PHS-SMCS/falcon-flight/images/README.md

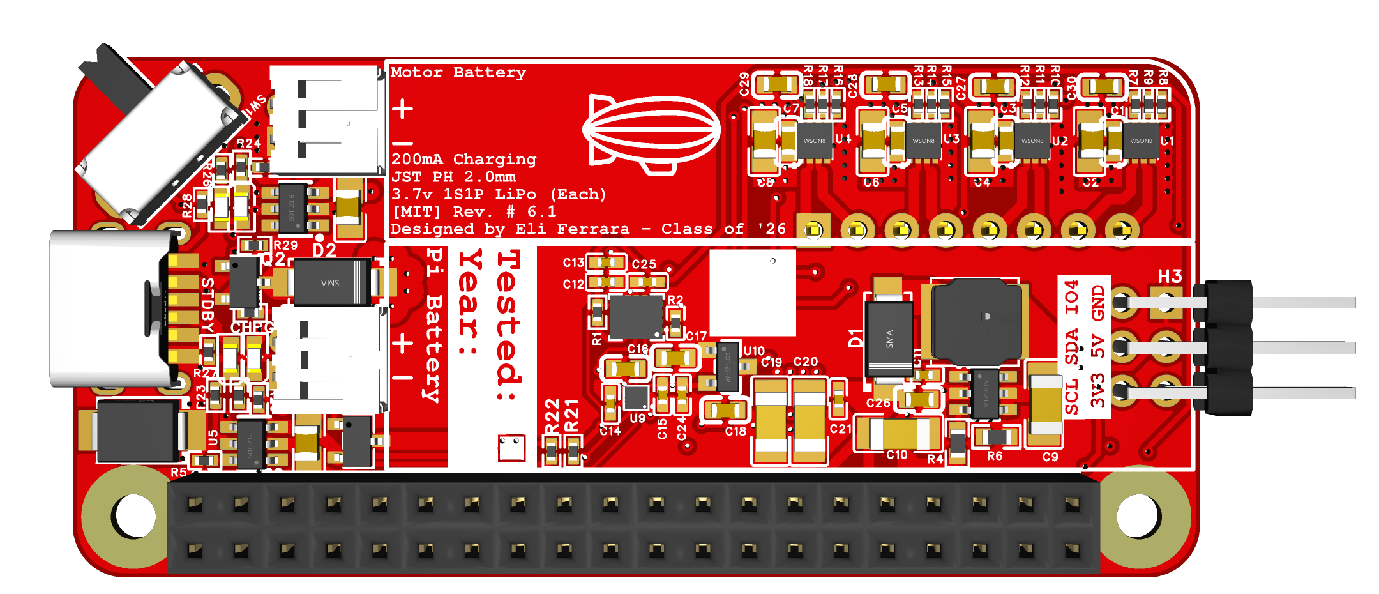
[picture p2: images/FFB6.1_3D_Top.png]
Falcon Flight embedded controller board 3D view (Top)


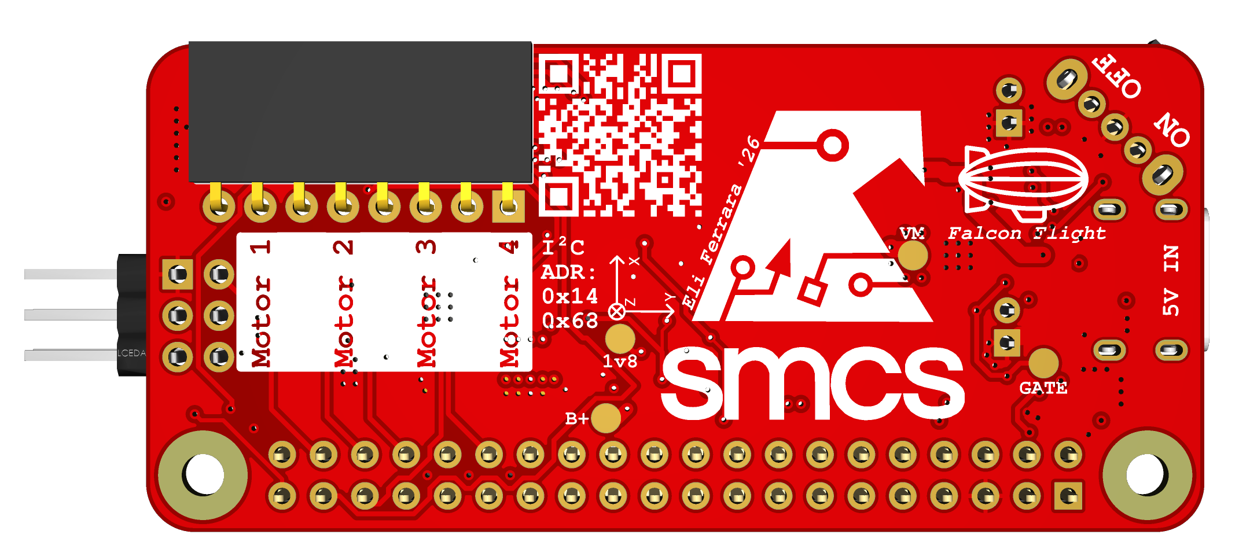
[picture p3: images/FFB6.1_3D_Bottom.png]
Falcon Flight embedded controller board 3D view (Bottom)


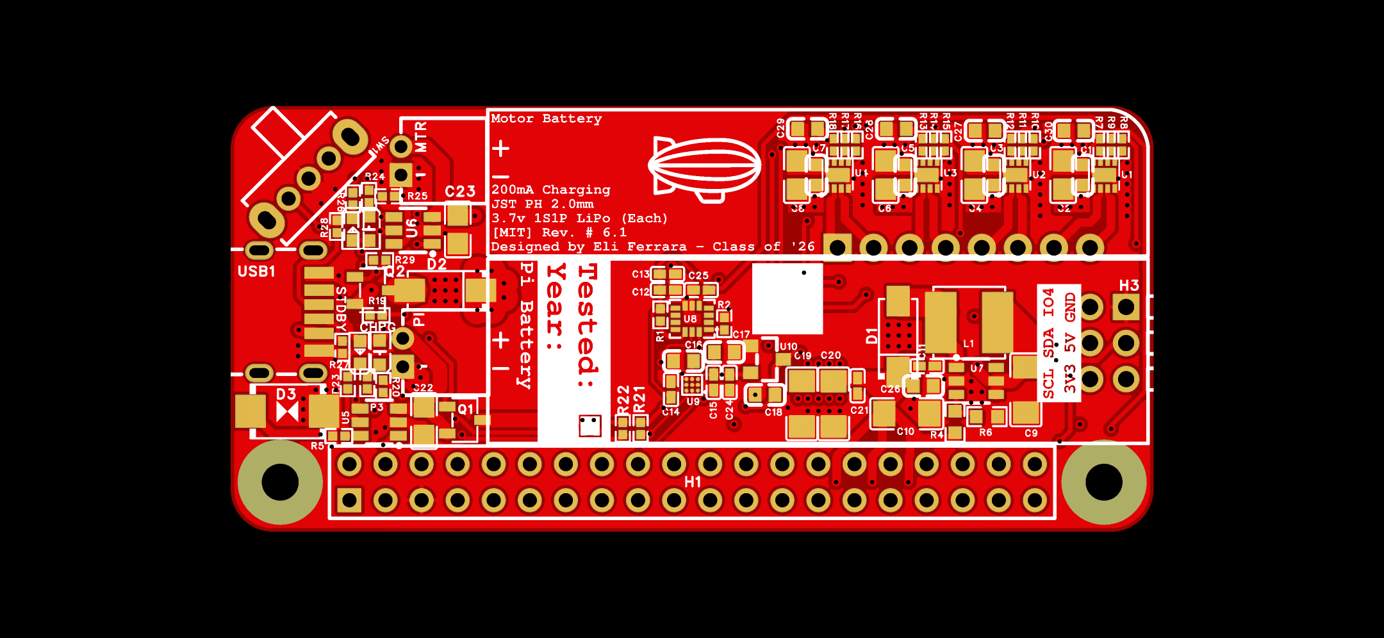
[picture p4: images/FFB6.1_2D_Top.png]
Falcon Flight embedded controller board 2D view (Top, no components)


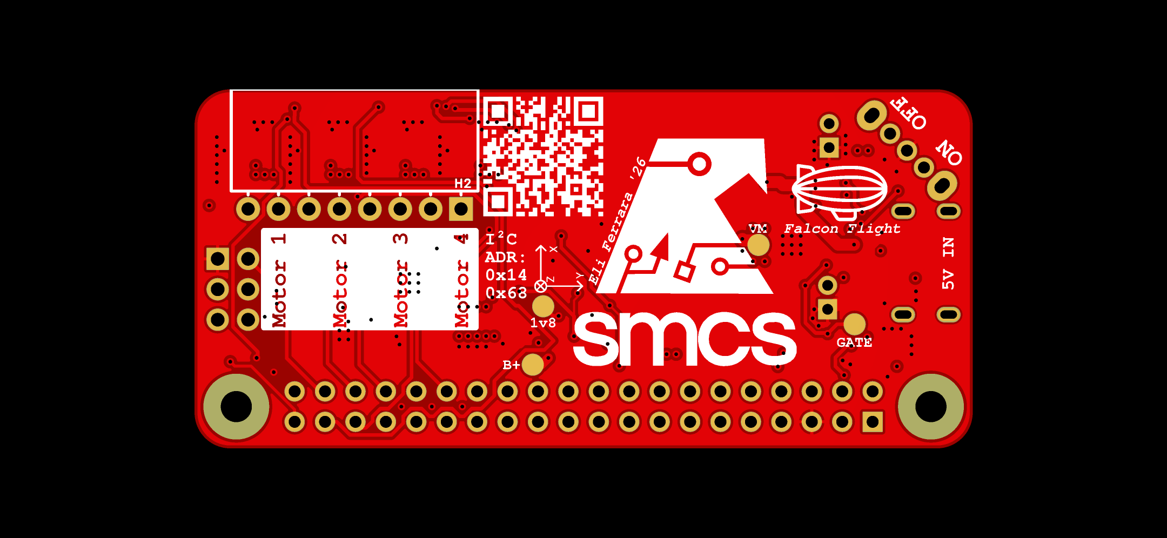
[picture p5: images/FFB6.1_2D_Bottom.png]
Falcon Flight embedded controller board 2D view (Bottom, no components)
