PHS-SMCS/falcon-flight/docs/FFB6.1_BOM.xlsx

No. | Quantity | Comment | Footprint | Value | Manufacturer Part | JLCPCB Price | JLCPCB Stock | Designator | JLCPCB Part Class | Supplier Part | LCSC Part Name | Name | Unique ID | Device
1 | 1 | 1uF | C0603 | 1uF | CL10A105KB8NNNC | 0.0007 | 16204341 | C26 | Basic Part | C15849 | 1uF ±10% 50V | 1uF | gge3106 | CL10A105KB8NNNC
2 | 1 | 6.8uH | IND-SMD_L5.0-W5.0 | 6.8uH | SWPA5020S6R8MT | 0.0137 | 2788 | L1 | Extended Part | C36410 | 6.8uH ±20% 2.05A | 6.8uH | gge3073 | SWPA5020S6R8MT
3 | 1 | 10uF | C1206 | 10uF | CL31A106KBHNNNE | 0.0048 | 2531080 | C20 | Basic Part | C13585 | 10uF ±10% 50V | 10uF | gge3098 | CL31A106KBHNNNE
4 | 1 | 30kΩ | R0603 |  | 0603WAF3002T5E | 0.0002 | 1803478 | R6 | Basic Part | C22984 |  | 30kΩ | gge31ab9c0f1dda5151 | 30kΩ
5 | 1 | 100nF | C0402 | 100nF | CL05B104KB54PNC | 0.0007 | 8856169 | C11 | Basic Part | C307331 | 100nF ±10% 50V | 100nF | gge3107 | CL05B104KB54PNC
6 | 1 | 100uF | C1206 | 100uF | CL31A107MQHNNNE | 0.01 | 1665954 | C19 | Basic Part | C15008 | 100uF ±20% 6.3V | 100uF | gge3097 | CL31A107MQHNNNE
7 | 1 | 100Ω | R0402 | 100Ω | 0402WGF1000TCE | 0.0001 | 5241737 | R29 | Basic Part | C25076 | 100Ω ±1% 62.5mW 厚膜电阻 | 100Ω | gge3145 | 0402WGF1000TCE
8 | 1 | 220kΩ | R0603 |  | 0603WAF2203T5E | 0.0002 | 779383 | R4 | Basic Part | C22961 |  | 220kΩ | ggefa30a2f02046dec0 | 220kΩ
9 | 1 | A2541WR-2x3P | HDR-TH_6P-P2.54-H-R2-C3-S2.54-W10.0_A2541WR |  | A2541WR-2x3P | 0.0145 | 67 | H3 | Extended Part | C239334 | 2x3P 间距:2.54mm 方针 弯插 | A2541WR-2x3P | gge3115 | A2541WR-2x3P
10 | 1 | BMI270 | LGA-14_L3.0-W2.5-P0.50-BR |  | BMI270 | 0.2565 | 14489 | U8 | Extended Part | C2836813 | BMI270 | BMI270 | gge3075 | BMI270
11 | 1 | BMM350 | WLCSP-9_L1.3-W1.3-R3-C3-P0.40-TL |  | BMM350 | 0.3041 | 3140 | U9 | Extended Part | C17225907 | SHUTTLE BOARD 3.0 BMM350 | BMM350 | gge3082 | BMM350_C17225907
12 | 1 | ME6206A18XG | SOT-23_L2.9-W1.3-P1.90-LS2.4-BR |  | ME6206A18XG | 0.0052 | 1772 | U10 | Extended Part | C236707 | 输入6V 输出1.8V 120mA | ME6206A18XG | gge3084 | ME6206A18XG
13 | 1 | MT3608 | SOT-23-6_L2.9-W1.6-P0.95-LS2.8-BR |  | MT3608 | 0.0084 | 116259 | U7 | Extended Part | C84817 |  | MT3608 | gge1bdc0ab44f99f92d | MT3608
14 | 1 | P6SMB6.8CA/TR13 | SMB_L4.6-W3.6-LS5.3-BI |  | P6SMB6.8CA/TR13 | 0.0072 | 249970 | D3 | Basic Part | C78395 | P6SMB6.8CA/TR13 | P6SMB6.8CA/TR13 | gge3103_1 | P6SMB6.8CA/TR13
15 | 1 | Pi Zero Header | HDR-TH_40P-P2.54-V-F-R2-C20-S2.54 |  | 2.54-2*20P母 | 0.0298 | 2 | H1 | Extended Part | C50982 |  | Pi Zero Header | gge60a270d9b08a2339 | Pi Zero Header
16 | 1 | PM254-1-08-W-8.5 | HDR-TH_8P-P2.54-H-F-W10.0-N |  | PM254-1-08-W-8.5 | 0.0243 | 158 | H2 | Extended Part | C2897390 | 1x8P 间距:2.54mm 弯插 | PM254-1-08-W-8.5 | gge3104_1 | PM254-1-08-W-8.5
17 | 1 | SK12D07VG3 | SW-TH_SK12D07VG3 |  | SK12D07VG3 | 0.0034 | 36037 | SW1 | Extended Part | C431547 | 两档位卧式拨动开关,柄长3MM | SK12D07VG3 | gge3071 | SK12D07VG3_C431547
18 | 1 | USB-TYPE-C-6PIN | USB-C-SMD-6P |  | TYPE-C-31-M-17 | 0.0259 | 3535 | USB1 |  | C283540 |  | USB-TYPE-C-6PIN | gge650f69c103efb29f_1 | USB-TYPE-C-6PIN
19 | 2 | 1kΩ | R0402 |  | 0402WGF1001TCE | 0.0001 | 10230811 | R3,R24 | Basic Part | C11702 |  | 1kΩ | gge3d69bb820fdd073a_1,gge3d69bb820fdd073a_3 | 1kΩ
20 | 2 | 2.2kΩ | R0402 | 2.2kΩ | 0402WGF2201TCE | 0.0001 | 2358701 | R21,R22 | Basic Part | C25879 | 2.2kΩ ±1% 62.5mW 厚膜电阻 | 2.2kΩ | gge3080,gge3081 | 0402WGF2201TCE
21 | 2 | 10uF | C0402 | 10uF | CL05A106MQ5NUNC | 0.0009 | 1838785 | C24,C25 | Basic Part | C15525 | 10uF ±20% 6.3V | 10uF | gge3101,gge3102 | CL05A106MQ5NUNC
22 | 2 | 10uF | C0805 |  | CL21A106KAYNNNE | 0.0016 | 8627909 | C22,C23 | Basic Part | C15850 |  | 10uF | gge6bc77ea4e09c62ca_1,gge6bc77ea4e09c62ca_2 | 10uF
23 | 2 | 22uF | C1206 | 22uF | CL31A226KAHNNNE | 0.0072 | 2097094 | C9,C10 | Basic Part | C12891 | 22uF ±10% 25V | 22uF | gge8af915fd353daa75,gge23753bbb746487b4 | CL31A226KAHNNNE
24 | 2 | Battery Connector | HDR-TH_2P-P2.00-H-F-W6.0 |  | Battery Connector | 0.0016 | 4907 | MTR,PI | Extended Part | C19271344 | 1x2P 间距:2mm 弯插 | Battery Connector | gge3072_2,gge3072_3 | XY-PH2.0-2A21
25 | 2 | DMP2035U-7 | SOT-23-3_L2.9-W1.6-P1.90-LS2.8-BR |  | DMP2035U-7 | 0.0084 | 82712 | Q1,Q2 | Extended Part | C110499 | 1个P沟道 耐压:20V 电流:3.6A | DMP2035U-7 | gge3112,gge3113 | DMP2035U-7
26 | 2 | NCD0603G3 | LED0603-RD |  | NCD0603G3 | 0.0012 | 48988 | STDBY,STDBY1 | Extended Part | C7429914 | NCD0603G3 | NCD0603G3 | gge3109,gge3111 | NCD0603G3
27 | 2 | RED_0603 | LED0603-R-RD |  | KT-0603R | 0.0008 | 4670572 | CHRG,CHRG1 | Basic Part | C2286 |  | RED_0603 | gge198_1,gge198_2 | RED_0603
28 | 2 | SS54 | SMA_L4.4-W2.8-LS5.4-R-RD |  | SS54 | 0.0061 | 1012443 | D1,D2 | Basic Part | C22452 | 电压:40V 电流:5A | SS54 | gge3150,gge3151 | SS54_C22452
29 | 2 | TP4057 | SOT-23-6_L2.9-W1.6-P0.95-LS2.8-BR |  | TP4057 | 0.0063 | 2992 | U5,U6 | Extended Part | C725791 | TP4057 | TP4057 | gge3108,gge3110 | TP4057
30 | 3 | 2.2uF | C0603 | 2.2uF | CL10A225KO8NNNC | 0.0009 | 4655966 | C16,C17,C18 | Basic Part | C23630 | 2.2uF ±10% 16V | 2.2uF | gge3083,gge3085,gge3086 | CL10A225KO8NNNC
31 | 4 | 5.1kΩ | R0402 |  | 0402WGF5101TCE | 0.0001 | 4244377 | R5,R25,R27,R28 | Basic Part | C25905 |  | 5.1kΩ | gge32fb4dae736d5b7f_2,ggeceda860c61fc78fa_1,ggeceda860c61fc78fa_2,ggeceda860c61fc78fa_3 | 5.1kΩ
32 | 4 | 22uF | C0805 | 22uF | CL21A226MAQNNNE | 0.0054 | 1988899 | C2,C4,C6,C8 | Basic Part | C45783 | 22uF ±20% 25V | 22uF | gge3138_1,gge3138_2,gge3138_3,gge3138_4 | CL21A226MAQNNNE
33 | 4 | 100kΩ | R0402 | 100kΩ | 0402WGF1003TCE | 0.0001 | 2837423 | R1,R2,R19,R20 | Basic Part | C25741 | 100kΩ ±1% 62.5mW 厚膜电阻 | 100kΩ | gge3076,gge3076_1,gge3076_2,gge3077 | 0402WGF1003TCE
34 | 4 | DRV8212PDSGR | WSON-8_L2.0-W2.0-P0.50-TL-EP |  | DRV8212PDSGR | 0.0583 | 81 | U1,U2,U3,U4 | Extended Part | C5208051 | DRV8212PDSGR | DRV8212PDSGR | gge3146,gge3147,gge3148,gge3149 | DRV8212PDSGR
35 | 5 | 100nF | C0402 | 100nF | CL05B104KO5NNNC | 0.0002 | 14759575 | C12,C13,C14,C15,C21 | Basic Part | C1525 | 100nF ±10% 16V | 100nF | gge23c53a2b242c8fec_1,gge3099,gge4817092b2fb4900c_1,gge4817092b2fb4900c_4,gge4817092b2fb4900c_5 | CL05B104KO5NNNC
36 | 6 | 10kΩ | R0402 | 10kΩ | 0402WGF1002TCE | 0.0001 | 15750299 | R9,R12,R15,R18,R23,R26 | Basic Part | C25744 | 10kΩ ±1% 62.5mW 厚膜电阻 | 10kΩ | gge3091_1,gge3091_2,gge3091_3,gge3091_4,gge3091_5,gge3124 | 0402WGF1002TCE
37 | 8 | 100nF | C0603 | 100nF | CC0603KRX7R9BB104 | 0.0004 | 57806501 | C1,C3,C5,C7,C27,C28,C29,C30 | Basic Part | C14663 | 100nF ±10% 50V | 100nF | gge3137_1,gge3137_2,gge3137_3,gge3137_4,gge3137_5,gge3137_6,gge3137_7,gge3137_8 | CC0603KRX7R9BB104
38 | 8 | 330Ω | R0402 | 330Ω | 0402WGF3300TCE | 0.0001 | 958879 | R7,R8,R10,R11,R13,R14,R16,R17 | Basic Part | C25104 | 330Ω ±1% 62.5mW 厚膜电阻 | 330Ω | gge3135_1,gge3135_2,gge3135_3,gge3135_4,gge3136_1,gge3136_2,gge3136_3,gge3136_4 | 0402WGF3300TCE
