PHS-SMCS/falcon-flight/docs/FFB6.1_Schematic.pdf

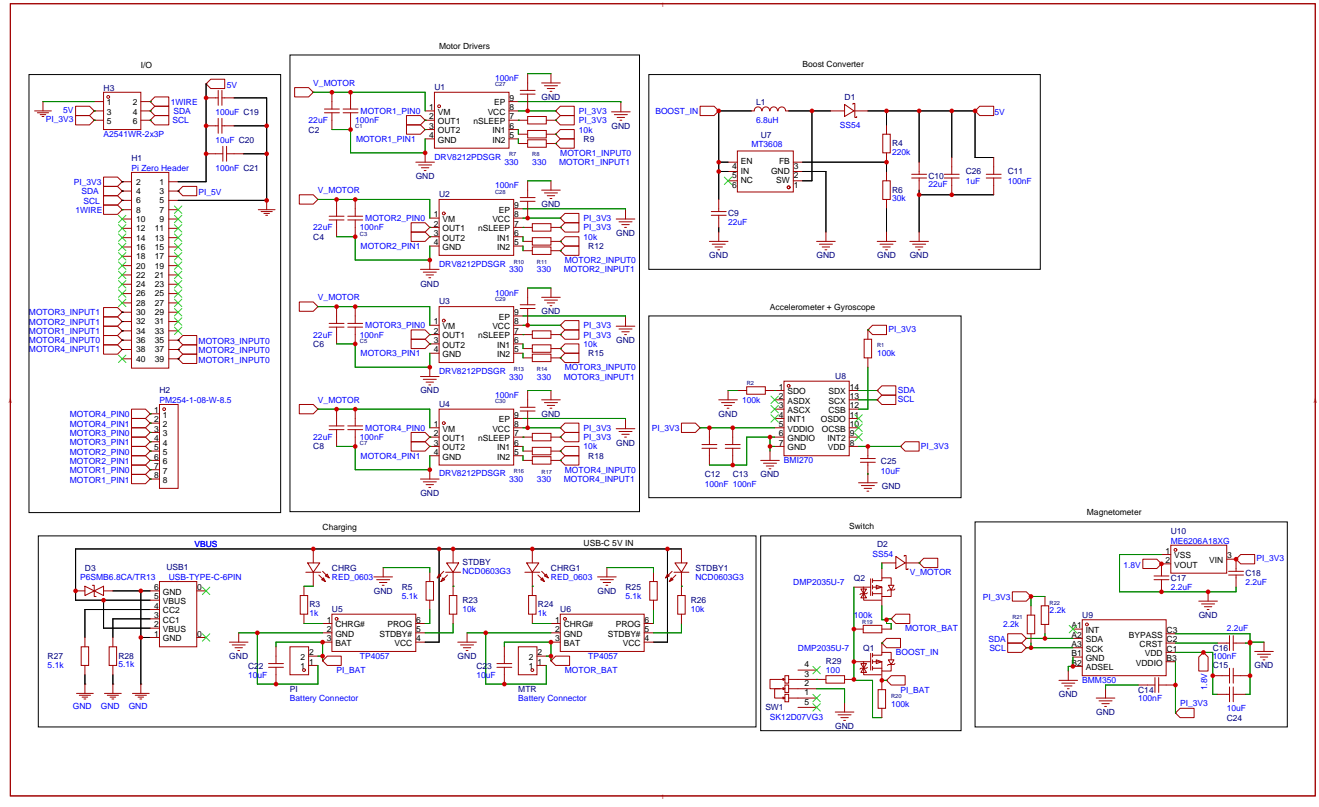
[picture p6: page 1]
