PHS-SMCS/falcon-flight/(list of files, drawings)

Other design files:
PCB/FFB6.1_EasyEDA_Pro_Document.epro
