PHS-SMCS/falcon-flight/(commit log)

2025-06-15 add datasheets, images, and fill out hardware docs
    [FFB6.1_BOM.xlsx, FFB6.1_EasyEDA_Pro_Document.epro]
2025-06-15 adjust schematic size + fix header lines
2025-06-15 scale images, add /images README.md + /PCB README.md
2025-06-15 replace ohm with Ω
